L40P/PlantCareHelper/documentation/Knopf.stl

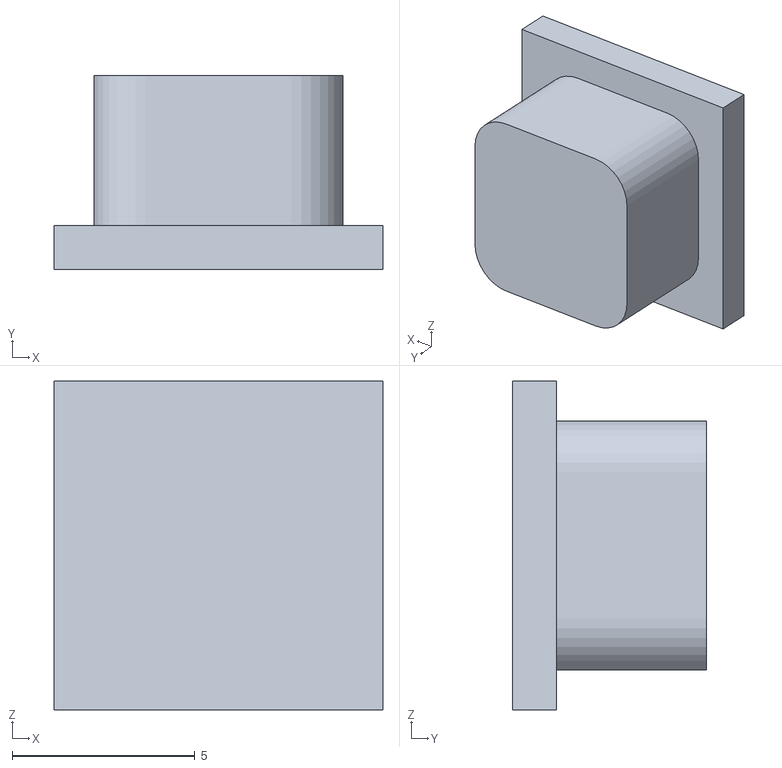
[picture p15: CAD file, 2023-01-17]
documentation/Knopf.stl
9.00 x 5.30 x 9.00
