L40P/PlantCareHelper/documentation/Hausing_Display.stl

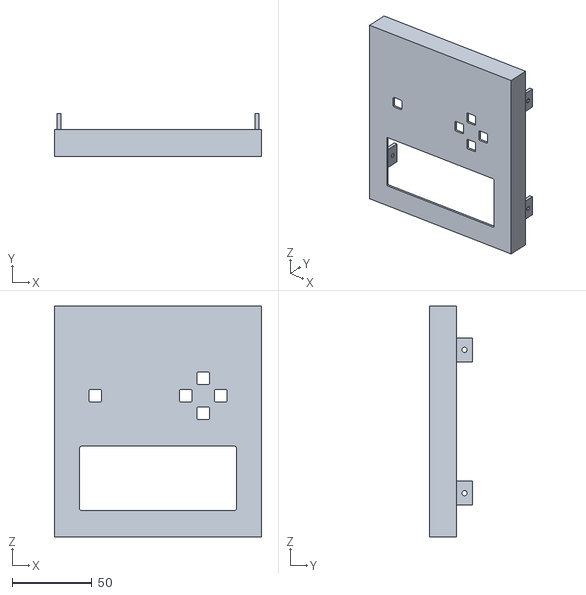
[picture p16: CAD file, 2023-01-17]
documentation/Hausing_Display.stl
130.0 x 27.0 x 145.0
