L40P/PlantCareHelper/(list of files, drawings)

Other design files:
documentation/Microcontrollers_Schaltung.fzz
