L40P/PlantCareHelper/(commit log)

2023-01-17 initial commit;
    [Hausing_Display.stl, Knopf.stl, Microcontrollers_Schaltung.fzz]
2023-01-18 added SerialManager; added debug prints; removed unused includes; increased baud rate; decreased sleep timeout; fixed Button;
    [Button.cpp, Button.h, Definitions.h, DisplayManager.cpp, MenuBattery.cpp, MenuPresetDisplay.cpp, MenuPresetDisplay.h]
